Kater--S/Kater-s-Word-Clock/README.md

# Kater's Word Clock

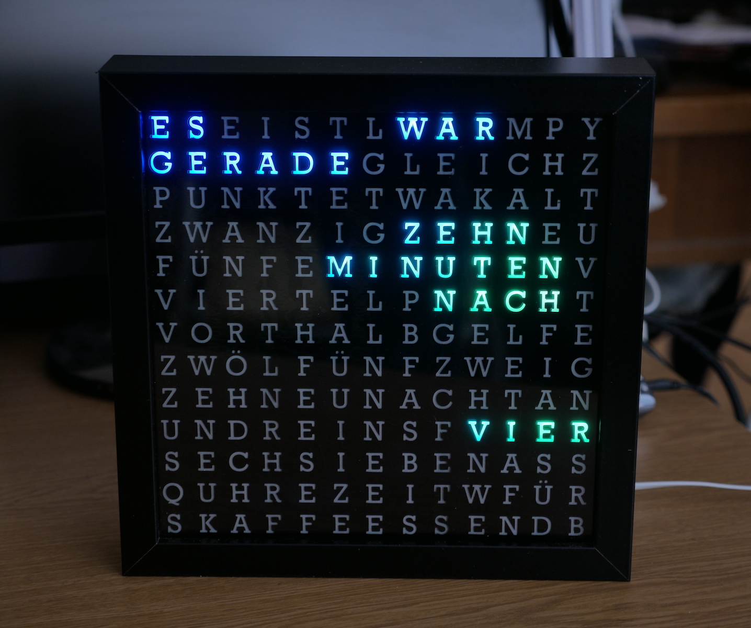
[picture p1: Pix/Clock.jpg]
04:12 PM


For now, please see German version in [LiesMich.md](LiesMich.md). English version will be provided in the future.
