Kater--S/Kater-s-Word-Clock/Pix/Cabling.png

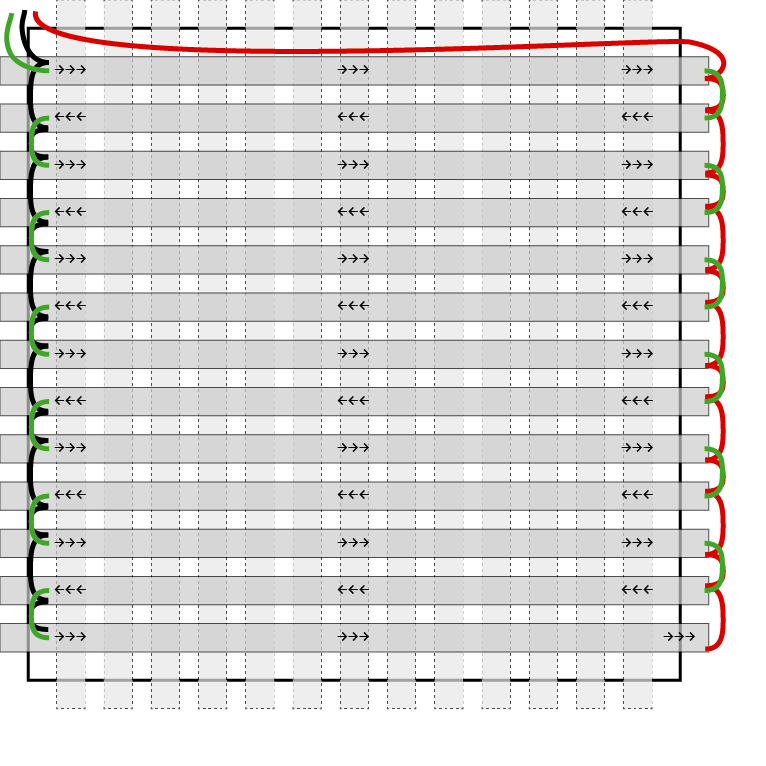
Pix/Cabling.png
