Kater--S/Kater-s-Word-Clock/Plotter/LED-Layout A4crop.png

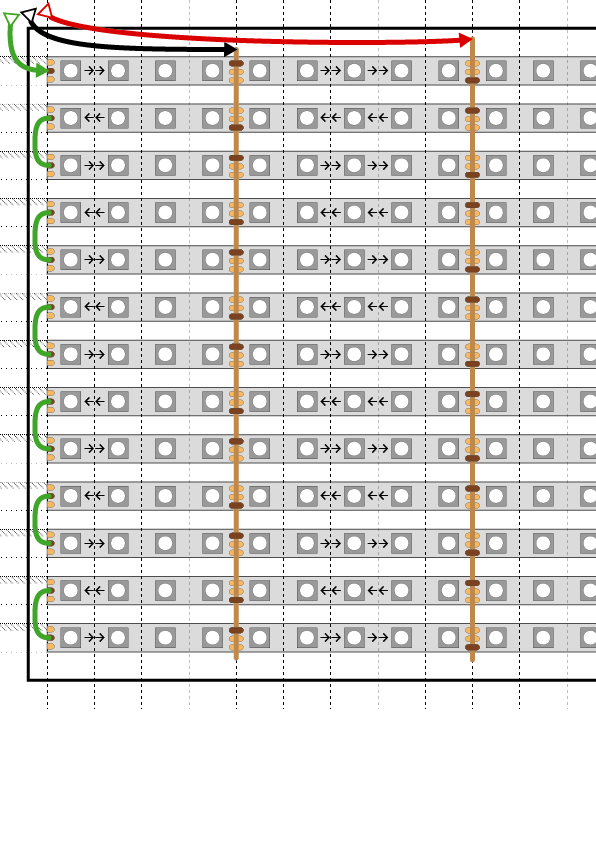
Plotter/LED-Layout A4crop.png
