Kater--S/Kater-s-Word-Clock/Plotter/LED-Layout komplett.png

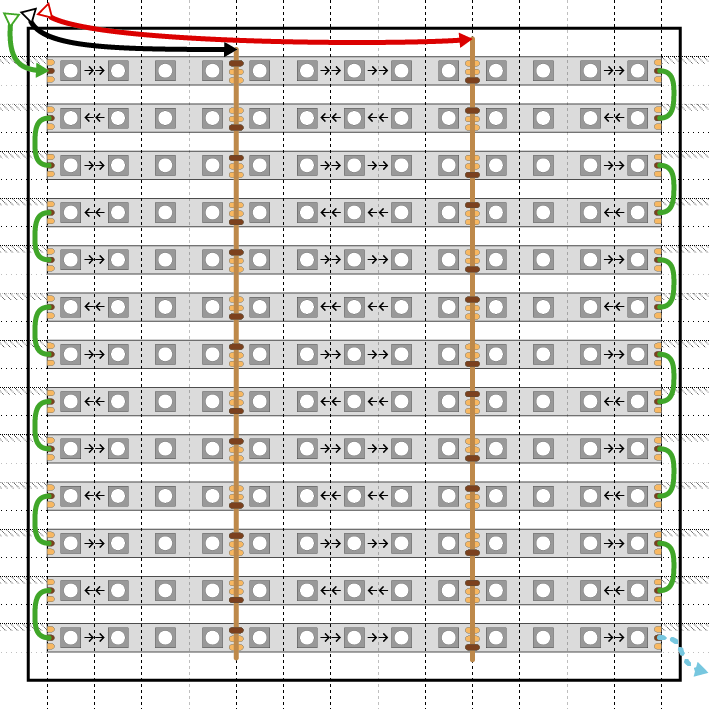
Plotter/LED-Layout komplett.png
