Kater--S/Kater-s-Word-Clock/3D_Printer/WordClockMatrix13x13_single.stl

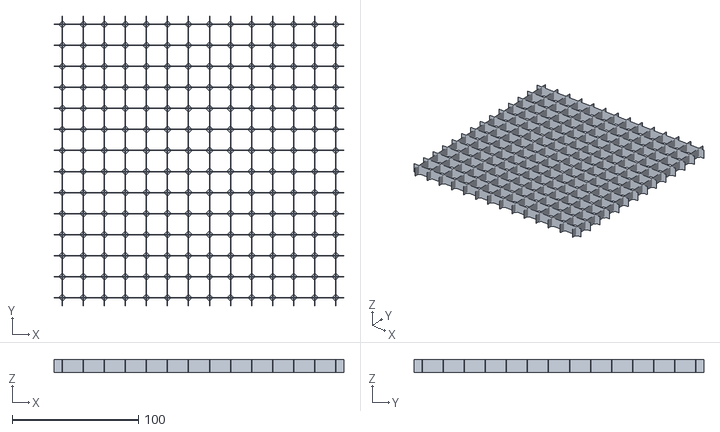
[picture p5: CAD file, 2019-04-08]
3D_Printer/WordClockMatrix13x13_single.stl
230.0 x 230.0 x 10.0
