Kater--S/Kater-s-Word-Clock/3D_Printer/FitTest.stl

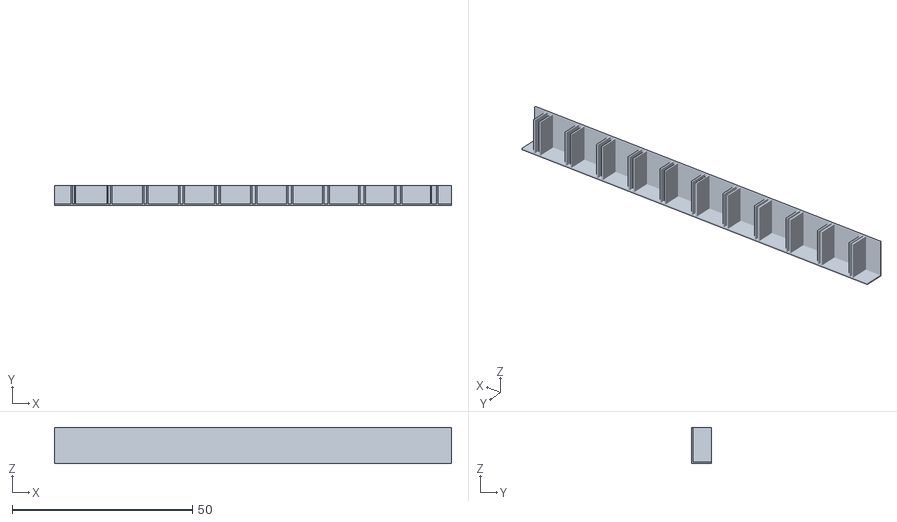
[picture p6: CAD file, 2019-04-08]
3D_Printer/FitTest.stl
110.0 x 5.56 x 10.0
