Kater--S/Kater-s-Word-Clock/3D_Printer/WordClockMatrix13x13_TEST5x5.stl

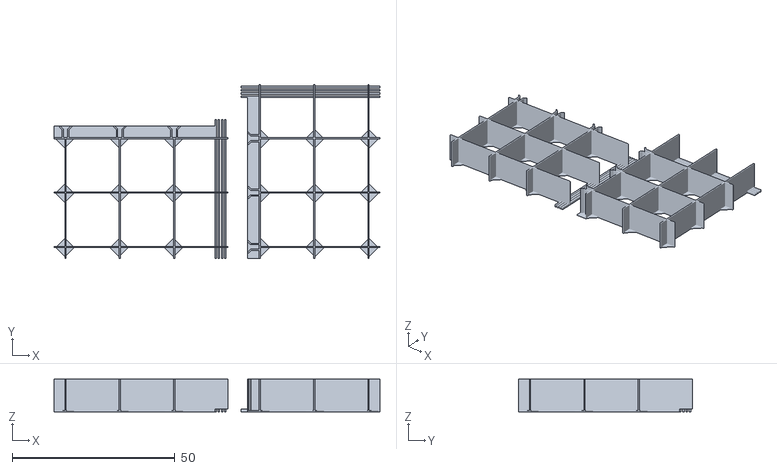
[picture p7: CAD file, 2019-04-08]
3D_Printer/WordClockMatrix13x13_TEST5x5.stl
100.0 x 53.3 x 10.0
