Kater--S/Kater-s-Word-Clock/3D_Printer/WordClockMatrix13x13_quarter.stl

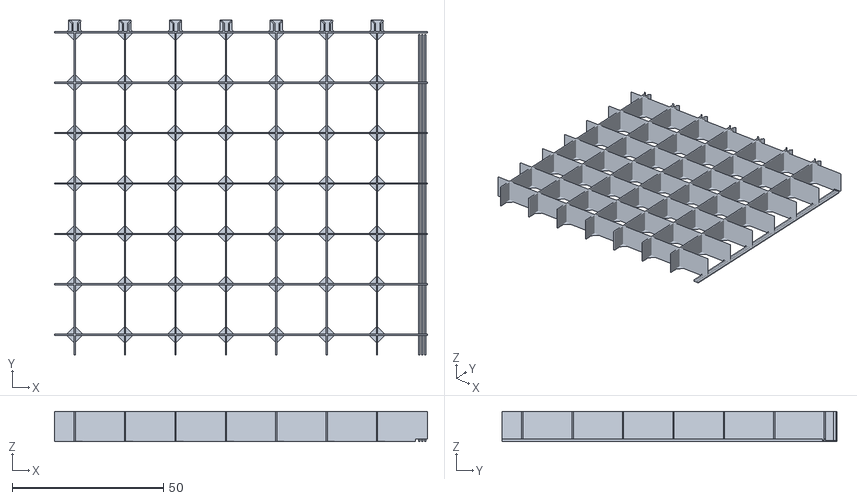
[picture p8: CAD file, 2019-04-08]
3D_Printer/WordClockMatrix13x13_quarter.stl
123.3 x 110.7 x 10.0
