Kater--S/Kater-s-Word-Clock/Plotter/LED-Layout.pdf

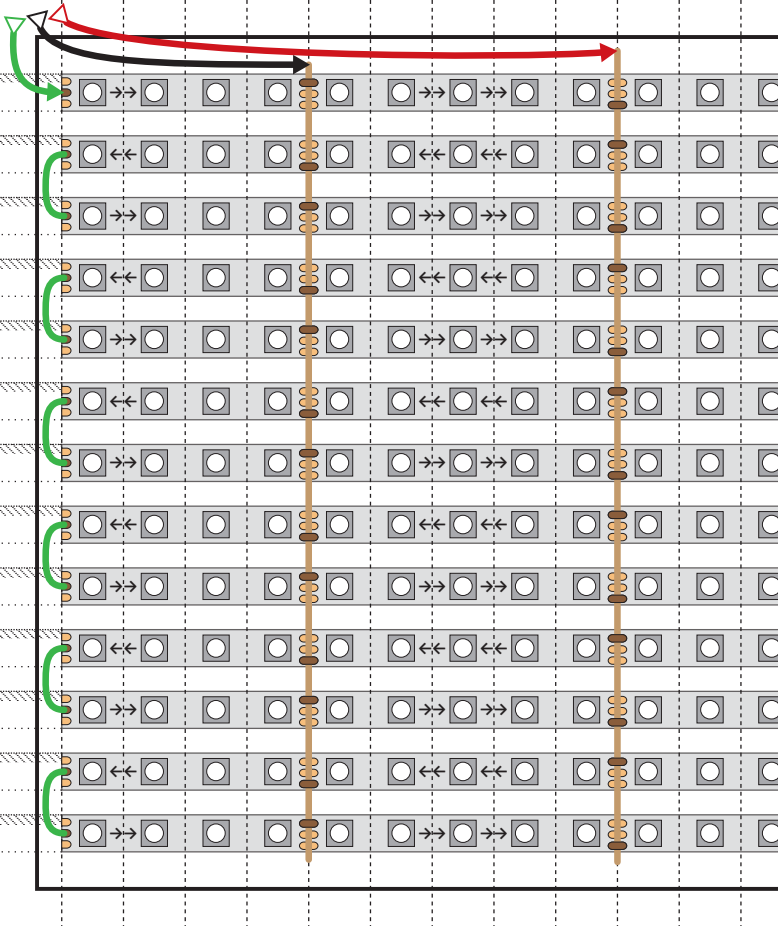
[picture p9: page 1]

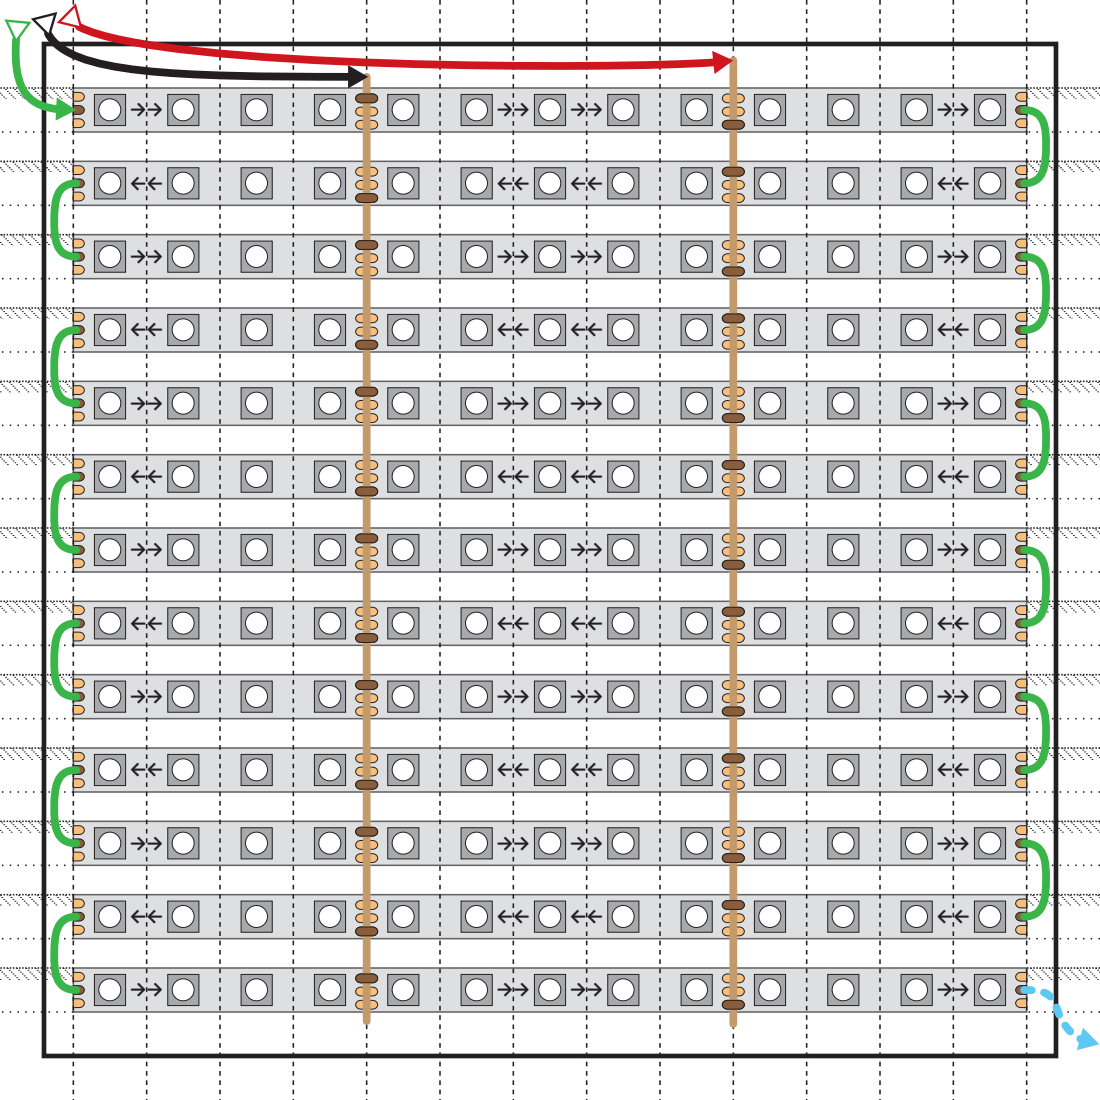
[picture p10: page 2]
