Kater--S/Kater-s-Word-Clock/Pix/ClockSetupPhase.jpg

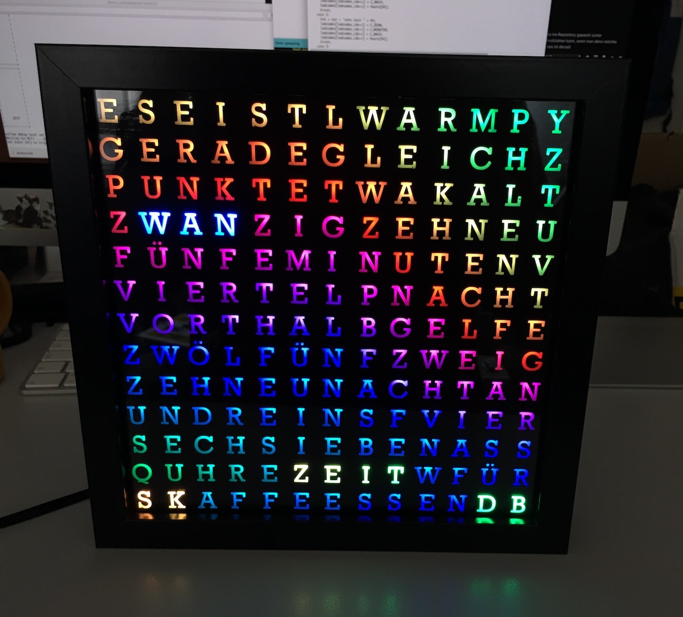
Pix/ClockSetupPhase.jpg
