Kater--S/Kater-s-Word-Clock/Pix/FitTest.png

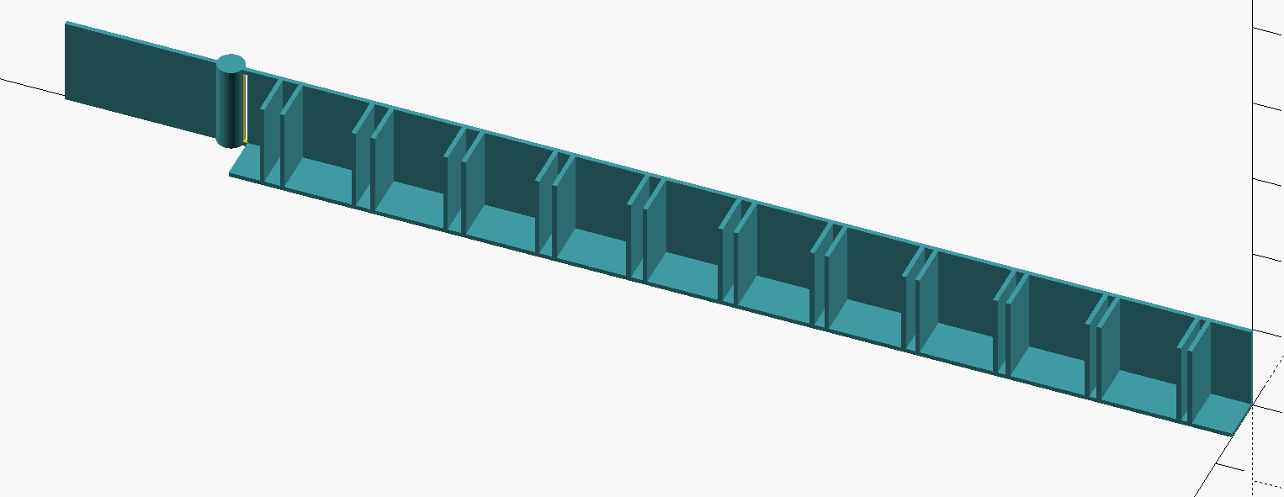
Pix/FitTest.png
