Kater--S/Kater-s-Word-Clock/ESP8266/WordClock_V1.4_WiFiManager/colorconv.h

// HSV->RGB conversion based on GLSL version
// expects hsv channels defined in 0.0 .. 1.0 interval

#define min(a,b) ((a)<(b)?(a):(b))

float fract(float x) { return x - int(x); }

float mix(float a, float b, float t) { return a + (b - a) * t; }

float step(float e, float x) { return x < e ? 0.0 : 1.0; }

float* hsv2rgb(float h, float s, float b, float* rgb) {
  rgb[0] = b * mix(1.0, constrain(abs(fract(h + 1.0) * 6.0 - 3.0) - 1.0, 0.0, 1.0), s);
  rgb[1] = b * mix(1.0, constrain(abs(fract(h + 0.6666666) * 6.0 - 3.0) - 1.0, 0.0, 1.0), s);
  rgb[2] = b * mix(1.0, constrain(abs(fract(h + 0.3333333) * 6.0 - 3.0) - 1.0, 0.0, 1.0), s);
  return rgb;
}

float* rgb2hsv(float r, float g, float b, float* hsv) {
  float s = step(b, g);
  float px = mix(b, g, s);
  float py = mix(g, b, s);
  float pz = mix(-1.0, 0.0, s);
  float pw = mix(0.6666666, -0.3333333, s);
  s = step(px, r);
  float qx = mix(px, r, s);
  float qz = mix(pw, pz, s);
  float qw = mix(r, px, s);
  float d = qx - min(qw, py);
  hsv[0] = abs(qz + (qw - py) / (6.0 * d + 1e-10));
  hsv[1] = d / (qx + 1e-10);
  hsv[2] = qx;
  return hsv;
}
