Kater--S/Kater-s-Word-Clock/(commit log)

2019-04-08 First Release
    [FitTest.stl, WordClockMatrix.scad, WordClockMatrix13x13_TEST5x5.stl, WordClockMatrix13x13_quarter.stl, WordClockMatrix13x13_single.stl]
2019-04-10 Fine Tuning
    wall thickness
    [WordClockMatrix.scad]
2019-04-11 Finetuning
    Edited description, included pix; better test object
    [WordClockMatrix.scad]
2020-03-13 Layout und Verkabelung verbessert
2020-03-15 use config.h.sample instead of config.h
2020-04-15 small changes + corrections
    [WordClock_V1.5_MQTT.ino]
2021-12-29 Improvements
    added "short" mode using less words
    [WordClock_V1.5_MQTT.ino]
2021-12-29 Bugfix
    ignore new message as long as one is still being displayed
    [WordClock_V1.6_Marquee.ino]
2021-12-30 Marquee improvements
    - intro animation before marquee is displayed
    - custom colors for intro and marquee
    - safety check for maximum current (reduced color values)
2021-12-30 Bugfix
    color specification
    config combination
    [WordClock_V1.6_Marquee.ino]
2022-01-01 Minor improvements
    info marquee upon startup,
    fixed seed value for first color map
    [WordClock_V1.6_Marquee.ino]
